shantig/downhill/cad/renders/pod_front34.png

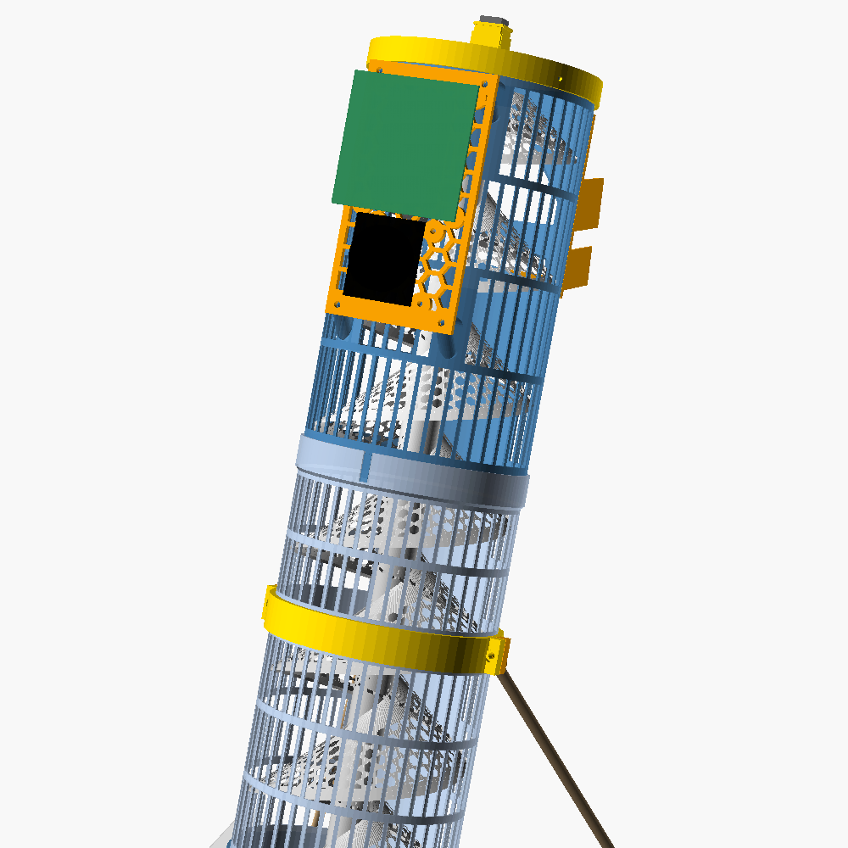
cad/renders/pod_front34.png
