shantig/downhill/cad/renders/exits_rear34.png

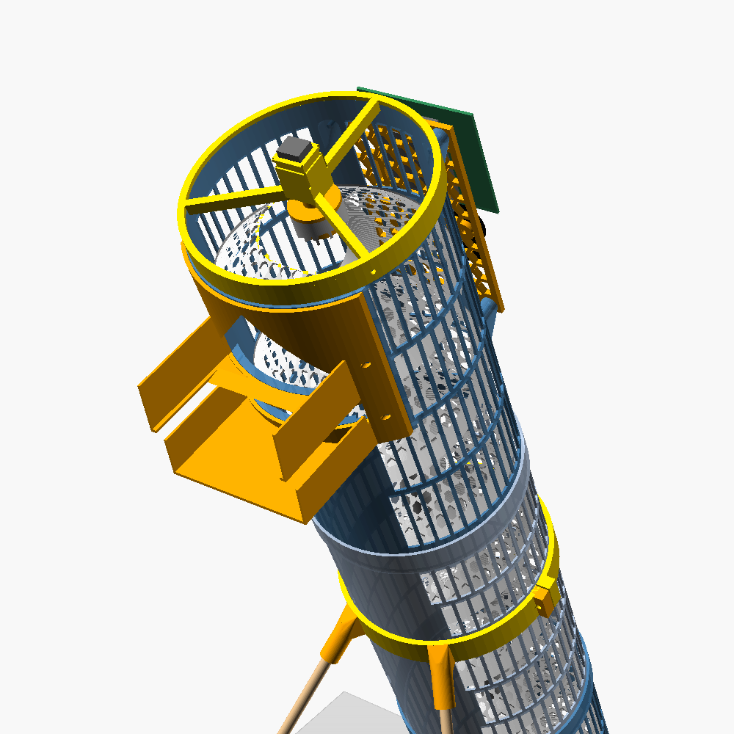
cad/renders/exits_rear34.png
