shantig/downhill/cad/renders/auger_middle.png

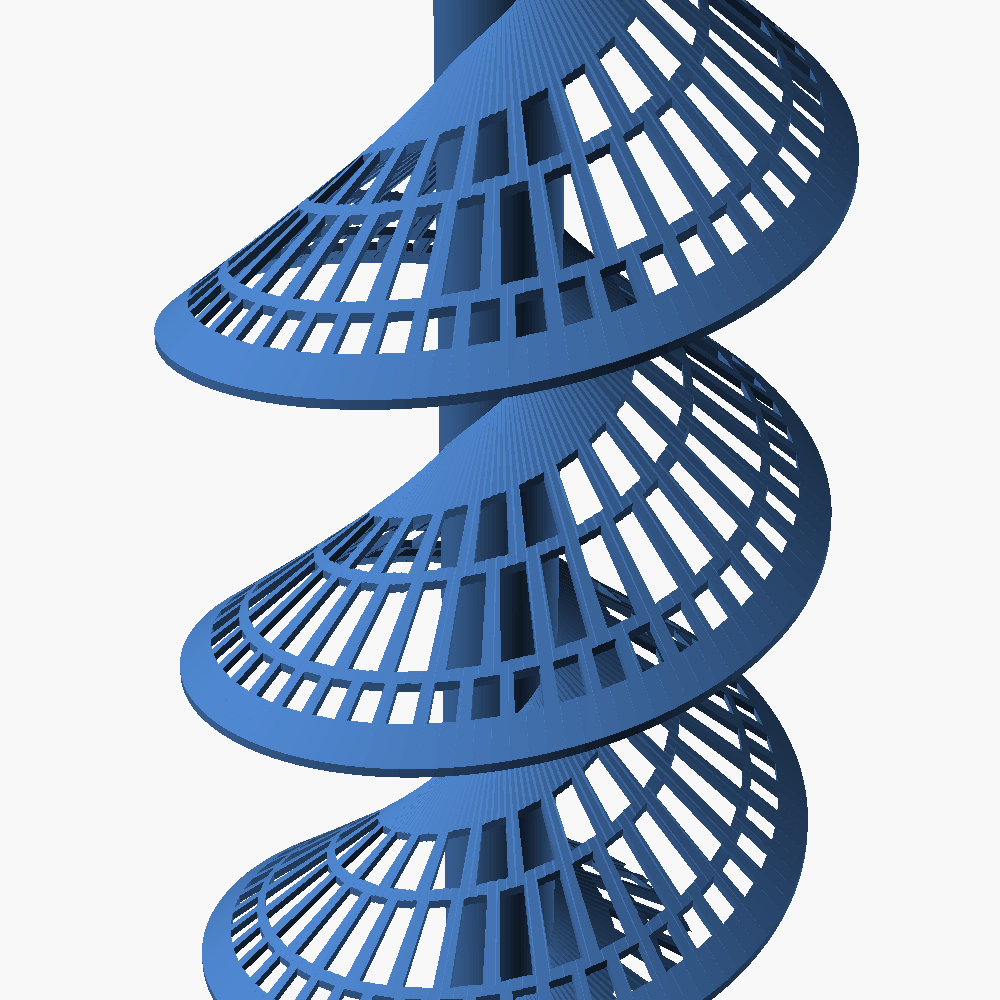
cad/renders/auger_middle.png
