shantig/downhill/cad/renders/side.png

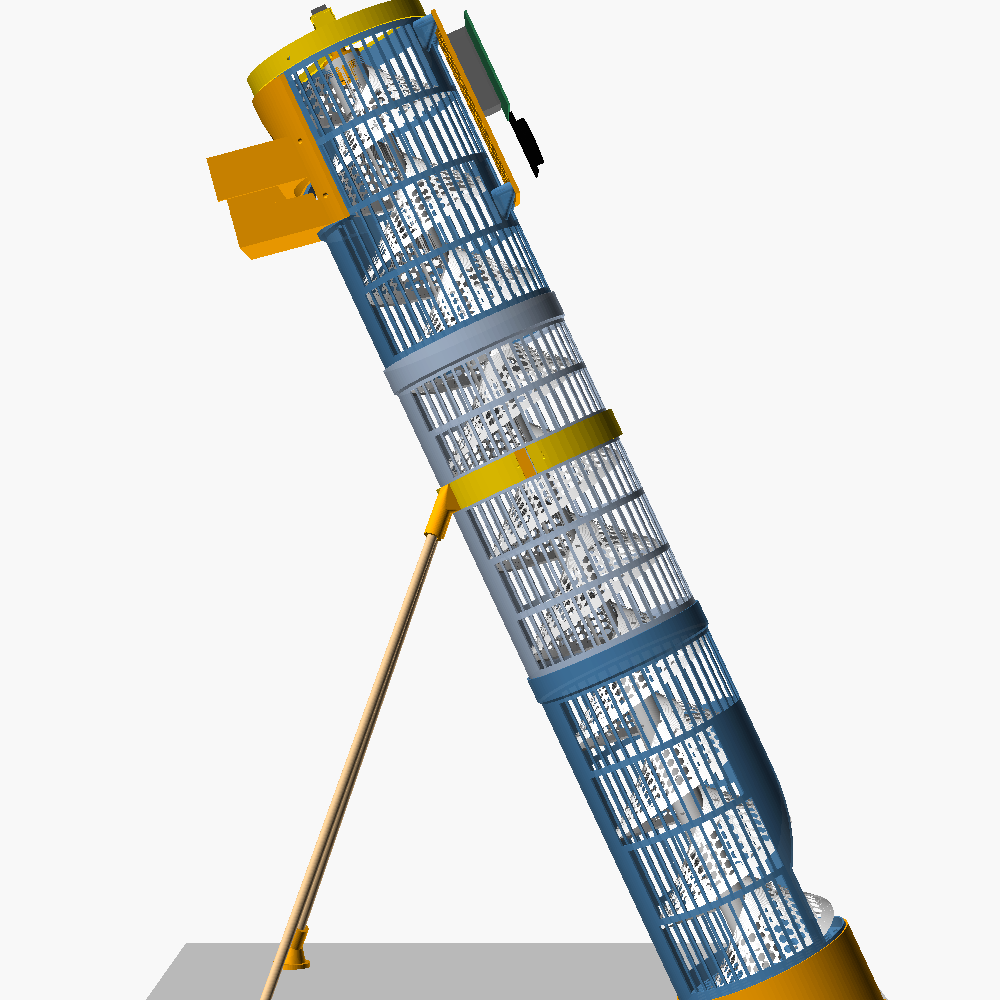
cad/renders/side.png
