shantig/downhill/cad/stl/shell_upper.stl

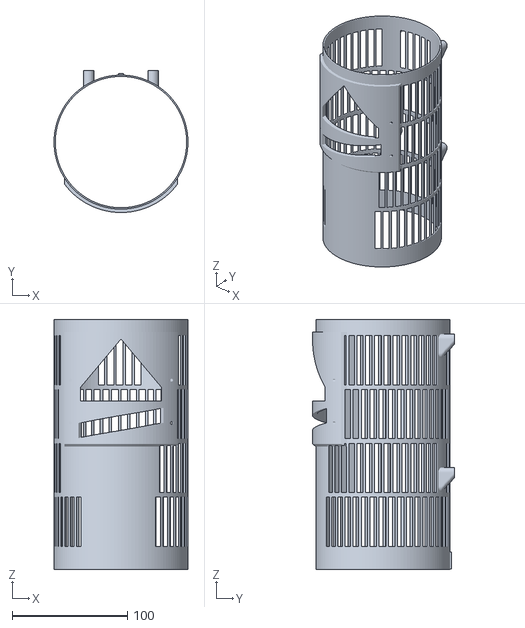
[picture p5: CAD file, 2026-11-13]
cad/stl/shell_upper.stl
116.4 x 123.4 x 217.2
