shantig/downhill/cad/stl/collar_back.stl

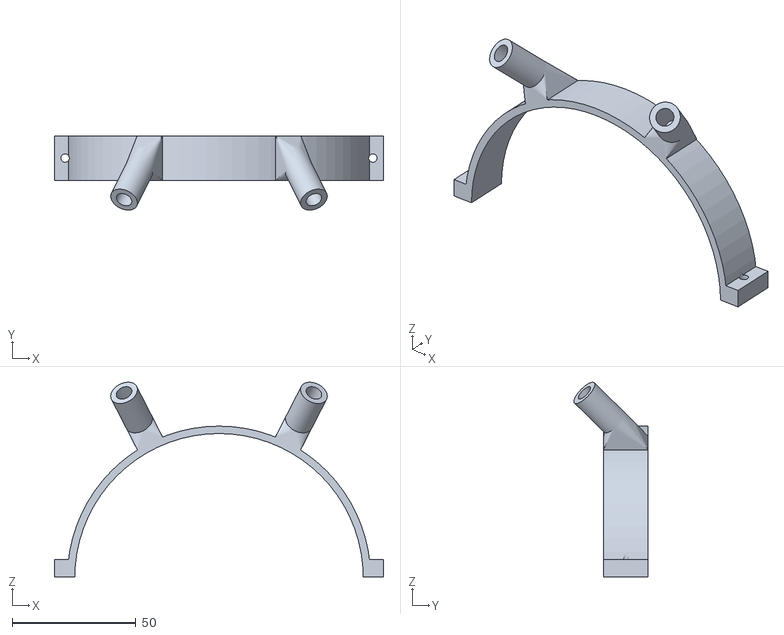
[picture p6: CAD file, 2026-11-13]
cad/stl/collar_back.stl
133.2 x 30.1 x 78.8
