shantig/downhill/cad/stl/collar_front.stl

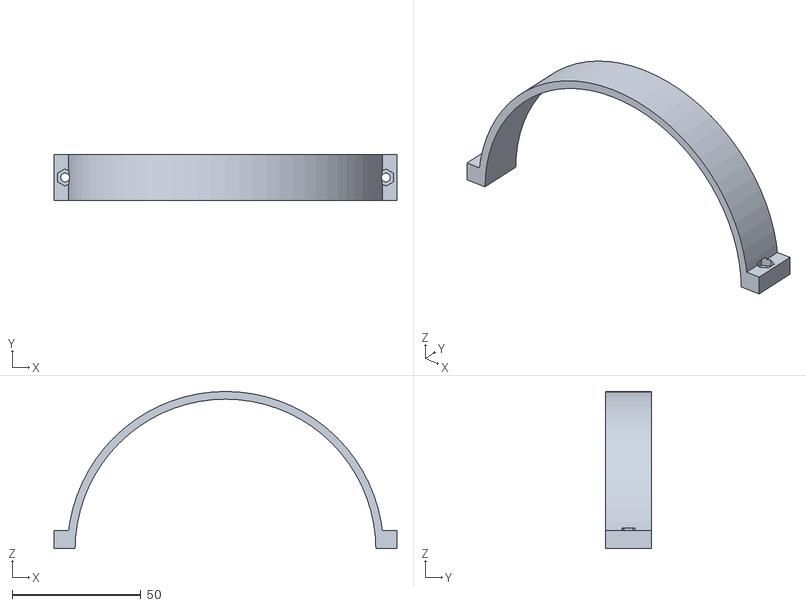
[picture p7: CAD file, 2026-11-13]
cad/stl/collar_front.stl
133.2 x 18.0 x 61.0
