shantig/downhill/cad/stl/foot_right.stl

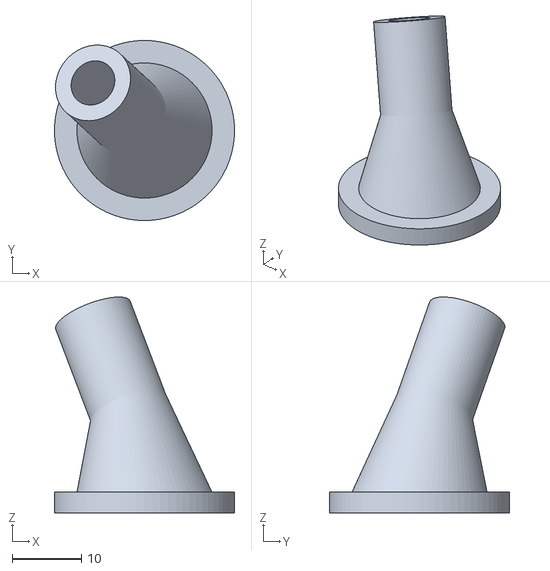
[picture p8: CAD file, 2026-11-13]
cad/stl/foot_right.stl
26.0 x 26.0 x 31.2
