shantig/downhill/cad/stl/shell_lower.stl

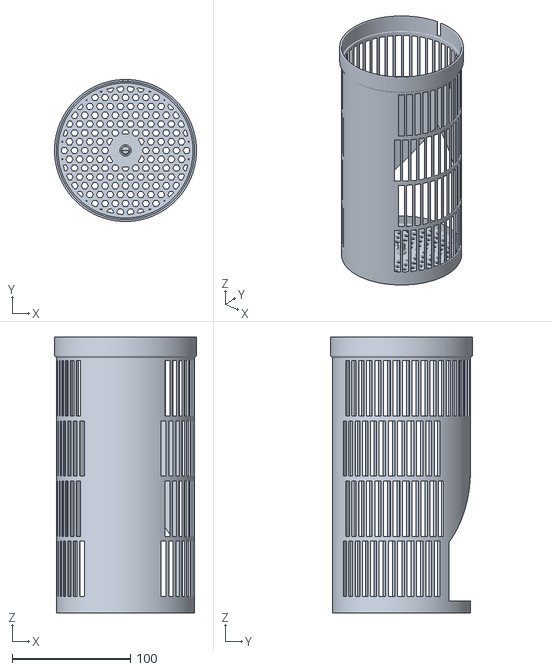
[picture p9: CAD file, 2026-11-13]
cad/stl/shell_lower.stl
119.9 x 119.9 x 233.0
