shantig/downhill/cad/stl/auger_middle.stl

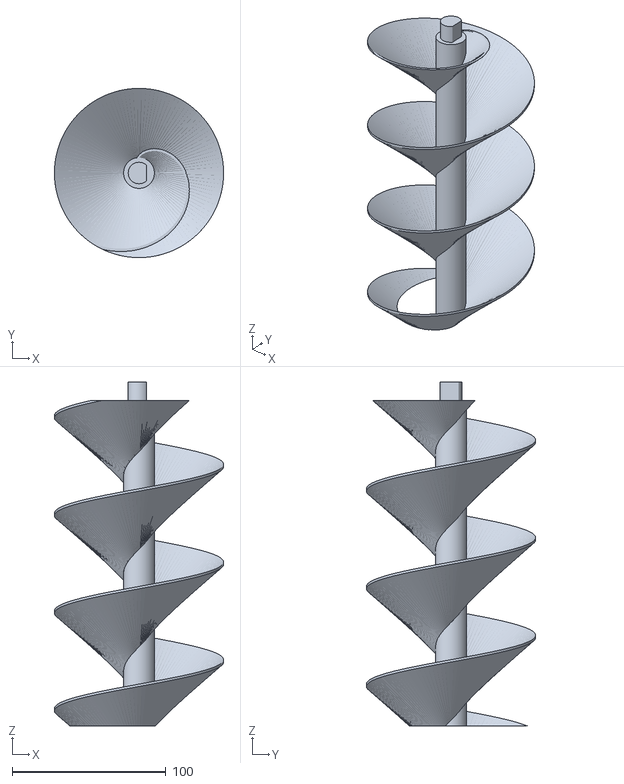
[picture p10: CAD file, 2026-11-13]
cad/stl/auger_middle.stl
110.0 x 110.0 x 223.7
