shantig/downhill/cad/stl/auger_lower.stl

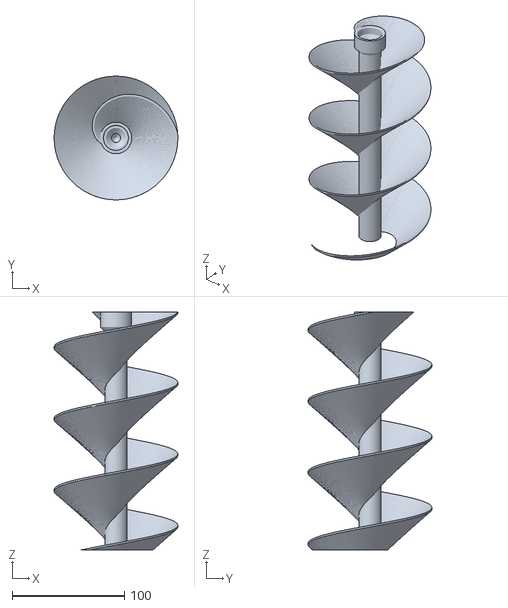
[picture p11: CAD file, 2026-11-13]
cad/stl/auger_lower.stl
110.0 x 110.0 x 211.7
