shantig/downhill/cad/stl/shell_middle.stl

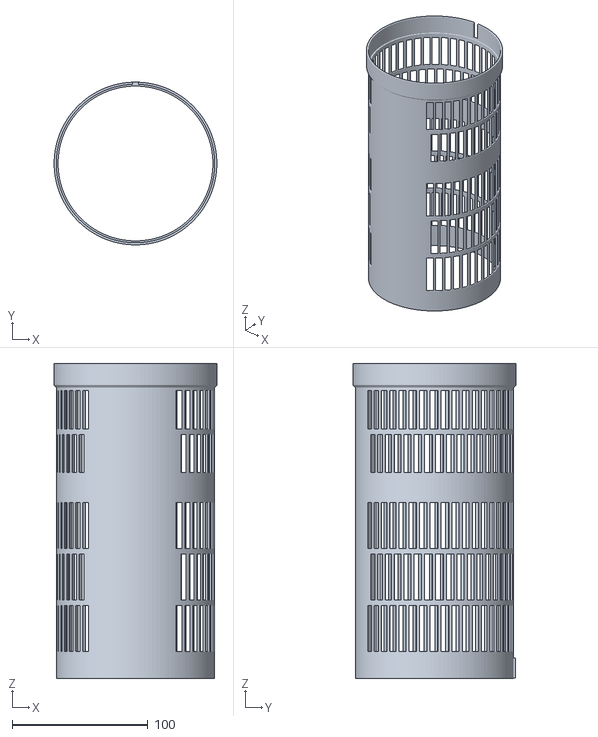
[picture p12: CAD file, 2026-11-13]
cad/stl/shell_middle.stl
119.9 x 119.9 x 232.0
