shantig/downhill/cad/stl/boot.stl

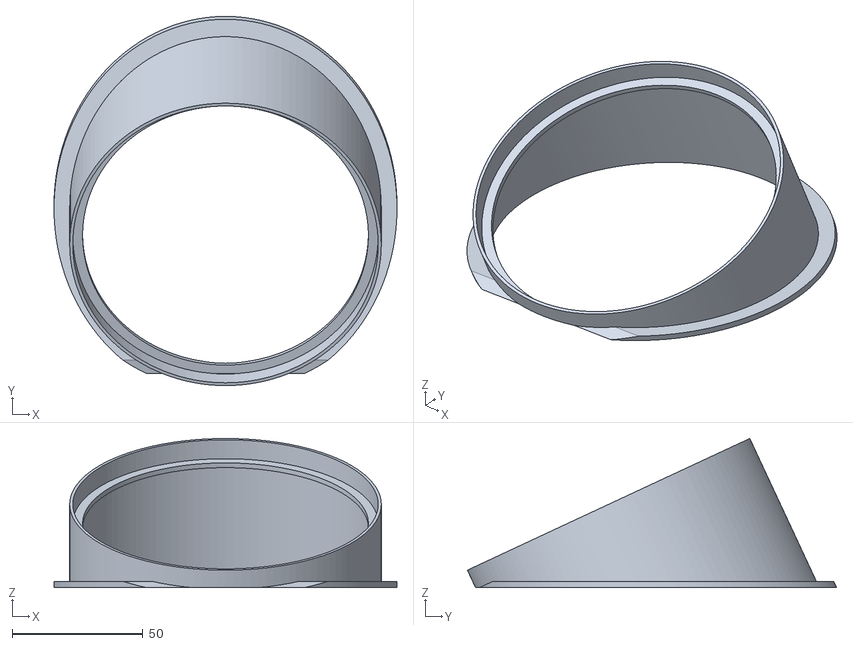
[picture p13: CAD file, 2026-11-13]
cad/stl/boot.stl
131.3 x 141.3 x 57.1
