shantig/downhill/cad/stl/spout_dowel.stl

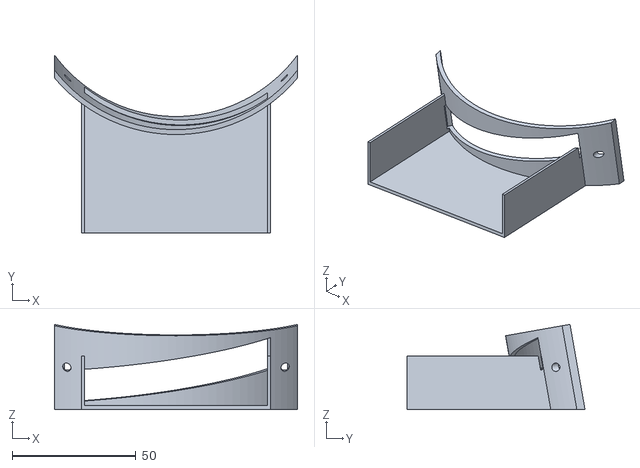
[picture p14: CAD file, 2026-11-13]
cad/stl/spout_dowel.stl
98.0 x 71.8 x 34.4
