shantig/downhill/cad/stl/spout_ball.stl

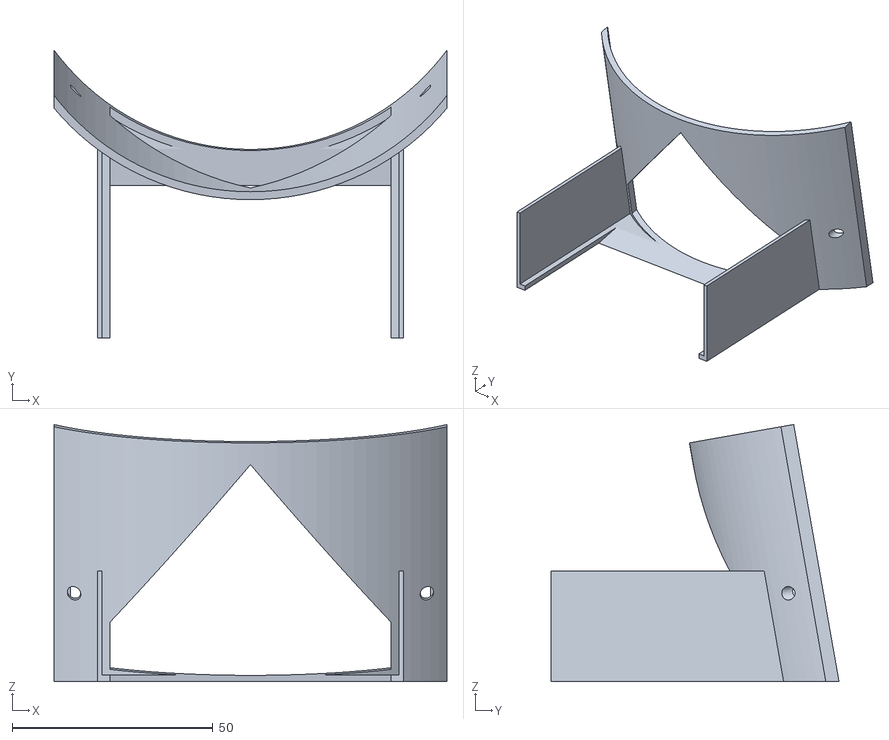
[picture p15: CAD file, 2026-11-13]
cad/stl/spout_ball.stl
98.0 x 71.8 x 64.1
