shantig/downhill/cad/stl/pod.stl

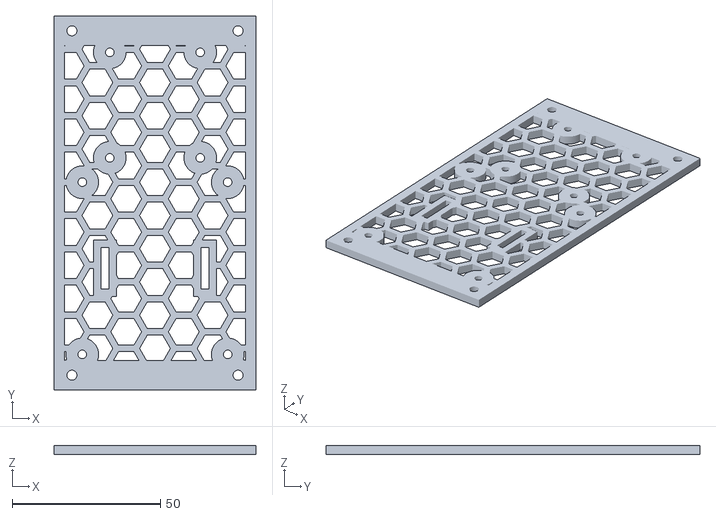
[picture p16: CAD file, 2026-11-13]
cad/stl/pod.stl
68.0 x 126.0 x 3.00
