shantig/downhill/cad/stl/motor_mount.stl

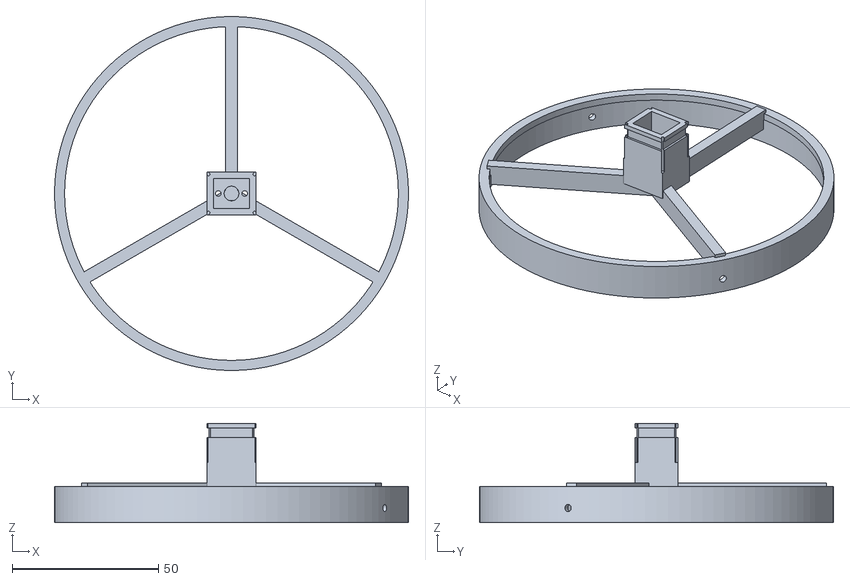
[picture p17: CAD file, 2026-11-13]
cad/stl/motor_mount.stl
120.9 x 120.9 x 33.9
