shantig/downhill/cad/stl/coupler.stl

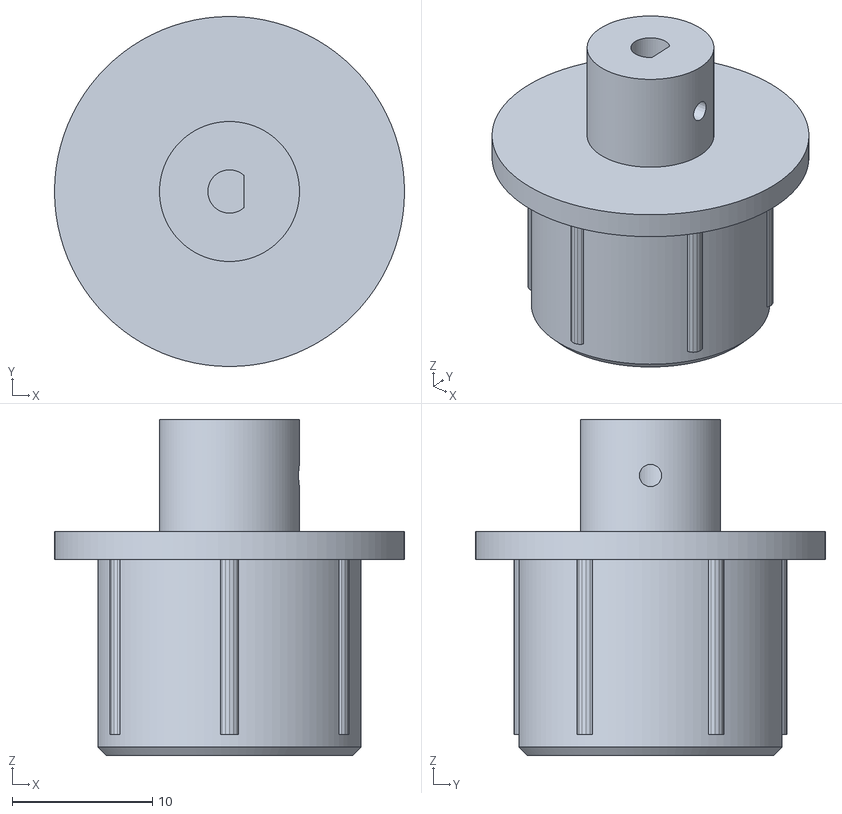
[picture p18: CAD file, 2026-11-13]
cad/stl/coupler.stl
25.0 x 25.0 x 24.0
