shantig/downhill/(list of files, cad)

Other CAD files:
cad/stl/foot_left.stl
cad/stl/auger_upper.stl
