shantig/downhill/include/RemoteControl.h

#pragma once

#include <Arduino.h>
#include <WebServer.h>

#include "Encoder.h"
#include "ControlCoordinator.h"
#include "MotorController.h"
#include "OTAUpdate.h"
#include "RotaryControl.h"
#include "SerialConsole.h"

class RemoteControl {
 public:
  RemoteControl(MotorController& motor, Encoder& encoder,
                ControlCoordinator& control, RotaryControl& rotary)
      : motor_(motor), encoder_(encoder), control_(control), rotary_(rotary),
        server_(80), ota_(server_, motor_, control_) {}

  void begin();
  void update();
  bool hasActiveLease() const { return remoteLeaseActive_; }

 private:
  void configureRoutes();
  void handleStatus();
  void handleDiagnostics();
  void handleSpeed();
  void handleDirection();
  void handleRun();
  void handleHeartbeat();
  void handleStop();
  void stopRemote(const __FlashStringHelper* reason);
  void revokeRemoteLeaseForUpdate();
  void sendJson(int statusCode, const String& body);
  bool requireArgument(const char* name);
  bool acceptRunCommandId();
  void observeCommandId();

  MotorController& motor_;
  Encoder& encoder_;
  ControlCoordinator& control_;
  RotaryControl& rotary_;
  WebServer server_;
  OTAUpdate ota_;
  bool remoteLeaseActive_ = false;
  uint32_t lastHeartbeatMs_ = 0;
  uint32_t remoteStops_ = 0;
  uint64_t lastRemoteCommandId_ = 0;
};
