shantig/downhill/(commit log)

2026-11-05 Add Downhill Dispatcher motor firmware
2026-11-09 Add rotary encoder motor control
2026-11-09 Replace GPIO rotary with ANO I2C control
    [BoardConfig.h, RemoteControl.cpp, RemoteControl.h, RotaryControl.cpp, RotaryControl.h, main.cpp]
2026-11-11 Reverse default motor direction
    [BoardConfig.h, MotorController.h, RotaryControl.cpp, RotaryControl.h]
2026-11-11 Update validation status of wireless controller
    Corrected the validation status of the wireless controller in the README.
2026-11-12 Remove motor operation section from README
    Removed motor operation instructions from README.
2026-11-13 CAD v1: auger shell, lean-back frame, N20 top drive
    Baseline mechanical CAD (OpenSCAD) before the Level 3 rework:
    auger v4 (381 mm, 2 pieces), two-piece shell with underside ball
    port + dowel slot, boot, spouts, electronics pod, frame, top drive.
    Claude-Session: https://claude.ai/code/session_01CDS3wzpV1djsU7eCzRA35p
    [auger.scad, boot.stl, collar_back.stl, collar_front.stl, coupler.stl, downhill_assembly.scad, downhill_frame.scad, downhill_shell.scad]
2026-11-13 CAD v2: Level 3 build, lighter, slicer-clean auger
    - Auger v5: 635 mm / 10 turns in 3 pieces, umbrella flight (+40 deg),
    1.2 mm solid flights, key moved to the bottom so pieces print
    upside down (no unsupported flight edge; 45 deg socket ends)
    - Shell v2: 650.8 mm in 3 dry-fit pieces, 1.2 mm wall, wider slotting,
    15 deg spouts; exits at 20.7 in (balls) / 19.6 in (dowels)
    - Frame: real shell dims, feet at +/-150 mm
    - Top drive: motor hub floor raised above the coupler boss (fixes a
    1.5 mm clash); motor_mount needs supports (build plate only)
    - export_all.sh regenerates every STL
    Claude-Session: https://claude.ai/code/session_01C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
    [auger.scad, auger_lower.stl, auger_middle.stl, auger_upper.stl, boot.stl, collar_back.stl, collar_front.stl, coupler.stl]
